ldgriffin88/go-kart-modeling/(list of files, cad)

Other CAD files:
cad-models/assemblies/Brake Caliper Assembly - Copy.SLDDRW
cad-models/assemblies/Brake Cylinder Assembly - Copy.SLDDRW
cad-models/assemblies/Brake Disc Assembly - Copy.SLDDRW
cad-models/assemblies/Front Right Subassembly - Copy.SLDDRW
cad-models/assemblies/Pedal Assembly - Copy.SLDDRW
cad-models/assemblies/Rear Axle Mount Assembly - Copy.SLDDRW
cad-models/assemblies/Rear Brake Assembly - Copy.SLDDRW
cad-models/assemblies/Rear Hub Assembly - Copy.SLDDRW
cad-models/assemblies/Sprocket Assembly - Copy.SLDDRW
cad-models/assemblies/Steering Rod Assembly - Copy.SLDDRW
cad-models/assemblies/Steering Wheel Assembly - Copy.SLDDRW
cad-models/parts/Brake Caliper - Original - Copy.SLDDRW
cad-models/parts/Brake Disc - Original - Copy.SLDDRW
cad-models/parts/Brake Disc Mount - Original - Copy.SLDDRW
cad-models/parts/Brake Frame Mount - Original - Copy.SLDDRW
cad-models/parts/Brake Lever - Original - Copy.SLDDRW
cad-models/parts/Brake Master Cyliner - Original - Copy.SLDDRW
cad-models/parts/Brake Mount - Original - Copy.SLDDRW
cad-models/parts/Brake Pad - Original - Copy.SLDDRW
cad-models/parts/Brake Pedal - Original - Copy.SLDDRW
cad-models/parts/Brake Piston - Original - Copy.SLDDRW
cad-models/parts/Engine Mount - Original - Copy.SLDDRW
cad-models/parts/Floor Plate - Original - Copy.SLDDRW
cad-models/parts/Floor Plate Tabs - Original - Copy.SLDDRW
cad-models/parts/Frame - Original - Copy.SLDDRW
cad-models/parts/Front Tire - Original - Copy.SLDDRW
cad-models/parts/Front Wheel Hub - Original - Copy.SLDDRW
cad-models/parts/Front Wheel Hub Connection - Original - Copy.SLDDRW
cad-models/parts/Gas Pedal - Original - Copy.SLDDRW
cad-models/parts/Half of Gear - Original - Copy.SLDDRW
cad-models/parts/Left Spindle - Original - Copy.SLDDRW
cad-models/parts/Pedal Rod - Original - Copy.SLDDRW
cad-models/parts/Rear Axle - Original - Copy.SLDDRW
cad-models/parts/Rear Axle Bearing Bracket - Original - Copy.SLDDRW
cad-models/parts/Rear Axle Bearing Mount - Original - Copy.SLDDRW
cad-models/parts/Rear Tire - Original - Copy.SLDDRW
cad-models/parts/Rear Wheel Hub - Original - Copy.SLDDRW
cad-models/parts/Rear Wheel Hub Connection - Original - Copy.SLDDRW
cad-models/parts/Spindle Collar - Original - Copy.SLDDRW
cad-models/parts/Sprocket Mount - Original - Copy.SLDDRW
cad-models/parts/Steering Rod - Original - Copy.SLDDRW
cad-models/parts/Steering Rod Standoff - Original - Copy.SLDDRW
cad-models/parts/Steering Shaft - Original - Copy.SLDDRW
cad-models/parts/Steering Wheel - Original - Copy.SLDDRW
