ldgriffin88/go-kart-modeling/drawings/assembly-drawings/Brake Caliper Assembly - Copy.pdf

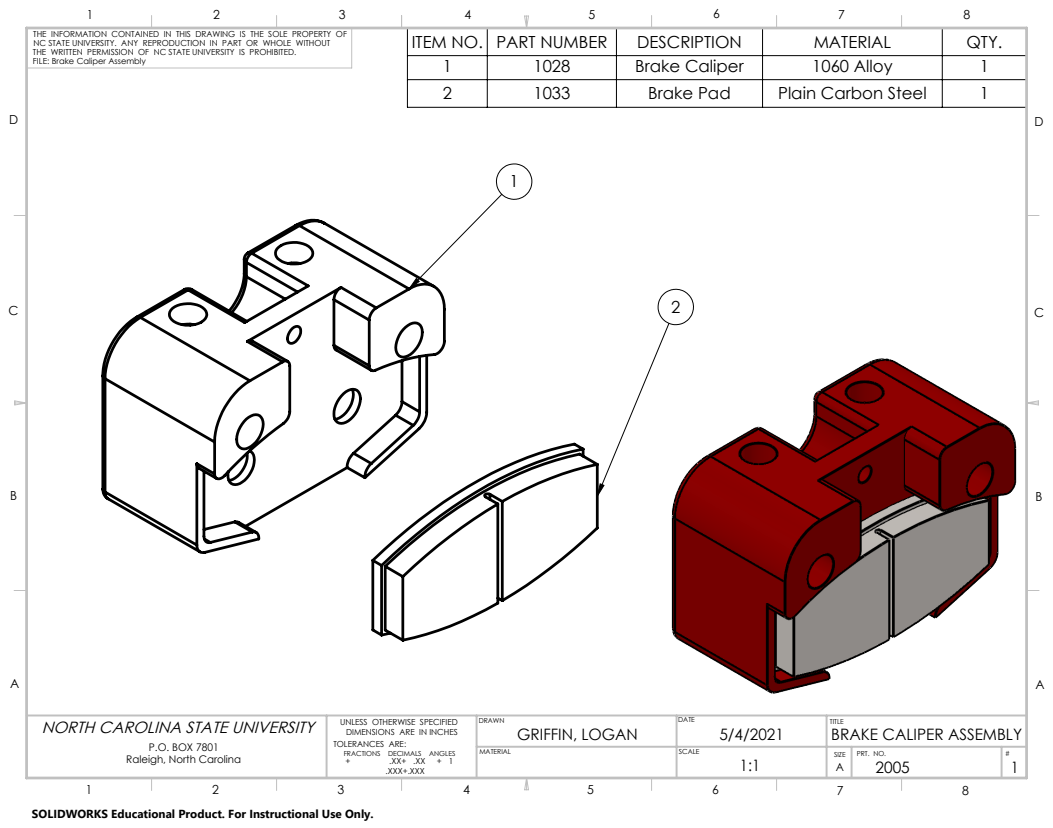
[picture p3: page 1]

THE INFORMATION CONTAINED IN THIS DRAWING IS THE SOLE PROPERTY OF
NC STATE UNIVERSITY. ANY REPRODUCTION IN PART OR WHOLE WITHOUT
THE WRITTEN PERMISSION OF NC STATE UNIVERSITY IS PROHIBITED.
FILE: Brake Caliper Assembly

ITEM NO. | PART NUMBER | DESCRIPTION | MATERIAL | QTY.
1 | 1028 | Brake Caliper | 1060 Alloy | 1
2 | 1033 | Brake Pad | Plain Carbon Steel | 1

P.O. BOX 7801 Raleigh, North Carolina | UNLESS OTHERWISE SPECIFIED NORTH CAROLINA STATE UNIVERSITY DIMENSIONS ARE IN INCHES TOLERANCES ARE: FRACTIONS DECIMALS ANGLES + .XX+ .XX + 1 .XXX+.XXX | DRAWN GRIFFIN, LOGAN MATERIAL | DATE 5/4/2021 | TITLE BRAKE CALIPER ASSEMBLY

SCALE 1:1 | SIZE A | PRT. NO. 2005 | # 1

SOLIDWORKS Educational Product. For Instructional Use Only.
