ldgriffin88/go-kart-modeling/drawings/assembly-drawings/Brake Cylinder Assembly - Copy.pdf

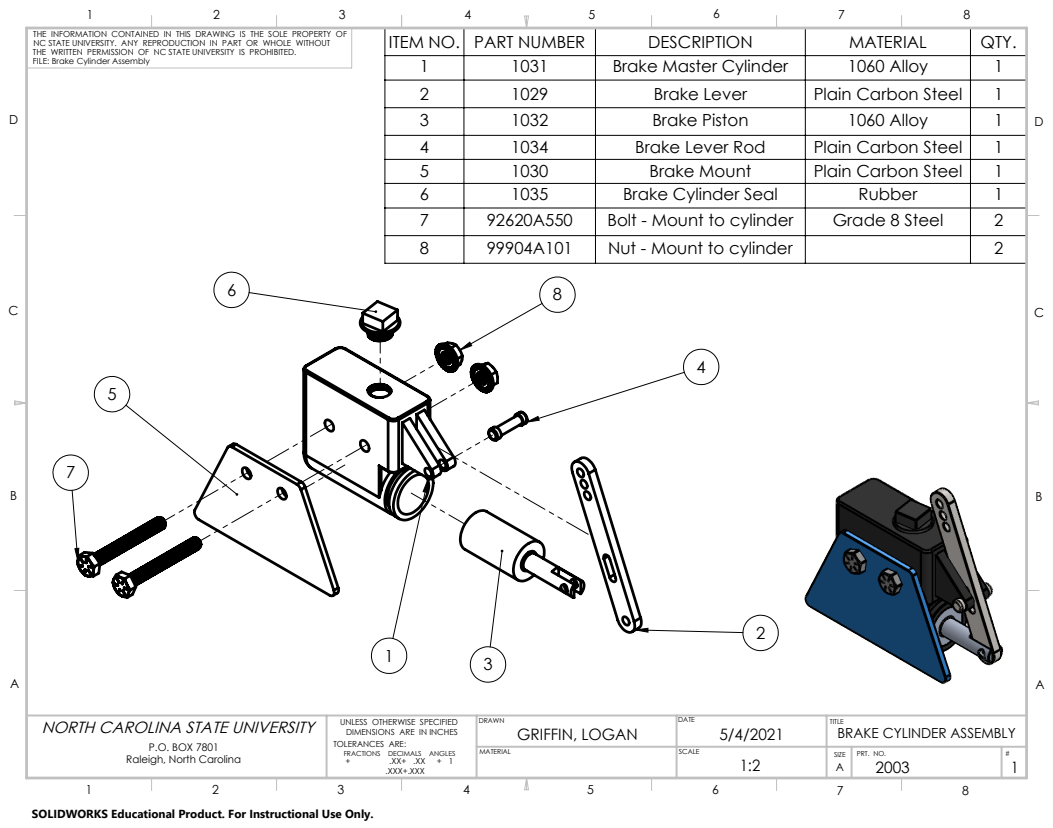
[picture p4: page 1]

THE INFORMATION CONTAINED IN THIS DRAWING IS THE SOLE PROPERTY OF
NC STATE UNIVERSITY. ANY REPRODUCTION IN PART OR WHOLE WITHOUT
THE WRITTEN PERMISSION OF NC STATE UNIVERSITY IS PROHIBITED.
FILE: Brake Cylinder Assembly

ITEM NO. | PART NUMBER | DESCRIPTION | MATERIAL | QTY.
1 | 1031 | Brake Master Cylinder | 1060 Alloy | 1
2 | 1029 | Brake Lever | Plain Carbon Steel | 1
3 | 1032 | Brake Piston | 1060 Alloy | 1
4 | 1034 | Brake Lever Rod | Plain Carbon Steel | 1
5 | 1030 | Brake Mount | Plain Carbon Steel | 1
6 | 1035 | Brake Cylinder Seal | Rubber | 1
7 | 92620A550 | Bolt - Mount to cylinder | Grade 8 Steel | 2
8 | 99904A101 | Nut - Mount to cylinder | | 2

P.O. BOX 7801 Raleigh, North Carolina | UNLESS OTHERWISE SPECIFIED NORTH CAROLINA STATE UNIVERSITY DIMENSIONS ARE IN INCHES TOLERANCES ARE: FRACTIONS DECIMALS ANGLES + .XX+ .XX + 1 .XXX+.XXX | DRAWN GRIFFIN, LOGAN MATERIAL | DATE 5/4/2021 | TITLE BRAKE CYLINDER ASSEMBLY

SCALE 1:2 | SIZE A | PRT. NO. 2003 | # 1

SOLIDWORKS Educational Product. For Instructional Use Only.
