ldgriffin88/go-kart-modeling/drawings/assembly-drawings/Brake Disc Assembly - Copy.pdf

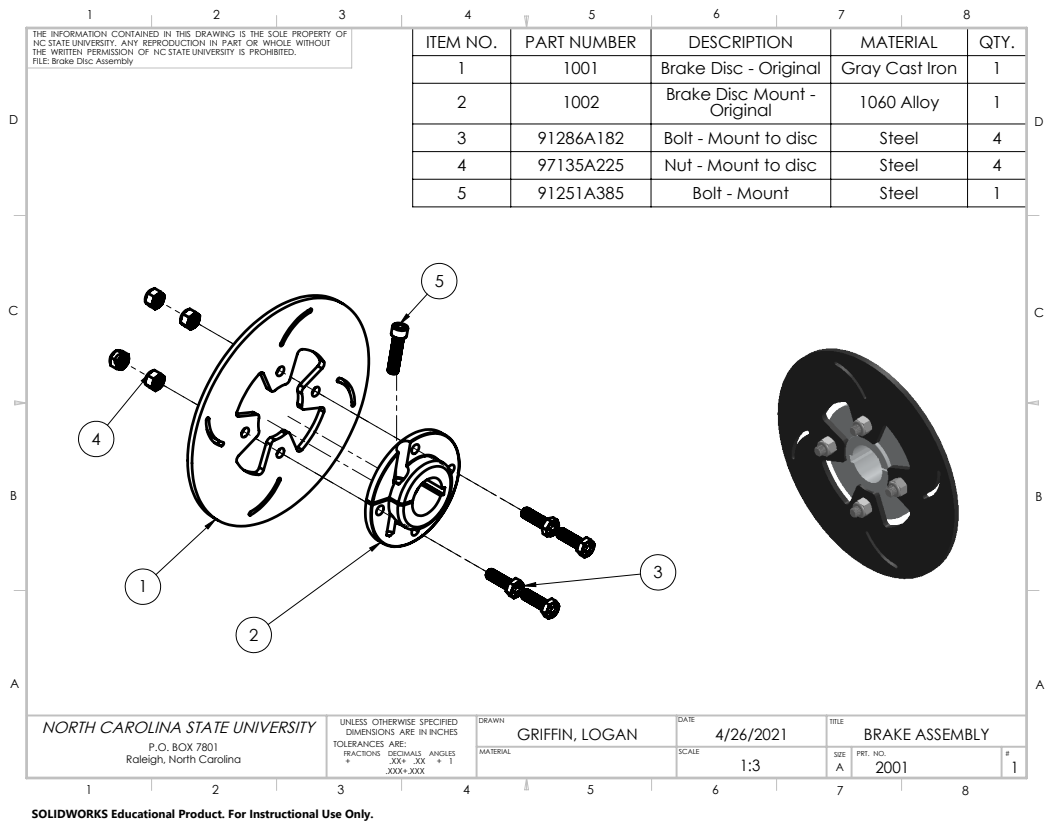
[picture p5: page 1]

THE INFORMATION CONTAINED IN THIS DRAWING IS THE SOLE PROPERTY OF
NC STATE UNIVERSITY. ANY REPRODUCTION IN PART OR WHOLE WITHOUT
THE WRITTEN PERMISSION OF NC STATE UNIVERSITY IS PROHIBITED.
FILE: Brake DIsc Assembly

ITEM NO. | PART NUMBER | DESCRIPTION | MATERIAL | QTY.
1 | 1001 | Brake Disc - Original | Gray Cast Iron | 1
2 | 1002 | Brake Disc Mount -Original | 1060 Alloy | 1

3 | 91286A182 | Bolt - Mount to disc | Steel | 4
4 | 97135A225 | Nut - Mount to disc | Steel | 4
5 | 91251A385 | Bolt - Mount | Steel | 1

P.O. BOX 7801 Raleigh, North Carolina | UNLESS OTHERWISE SPECIFIED NORTH CAROLINA STATE UNIVERSITY DIMENSIONS ARE IN INCHES TOLERANCES ARE: FRACTIONS DECIMALS ANGLES + .XX+ .XX + 1 .XXX+.XXX | DRAWN GRIFFIN, LOGAN MATERIAL | DATE 4/26/2021 | TITLE BRAKE ASSEMBLY

SCALE 1:3 | SIZE A | PRT. NO. 2001 | # 1

SOLIDWORKS Educational Product. For Instructional Use Only.
