ldgriffin88/go-kart-modeling/drawings/assembly-drawings/Front Right Subassembly - Copy.pdf

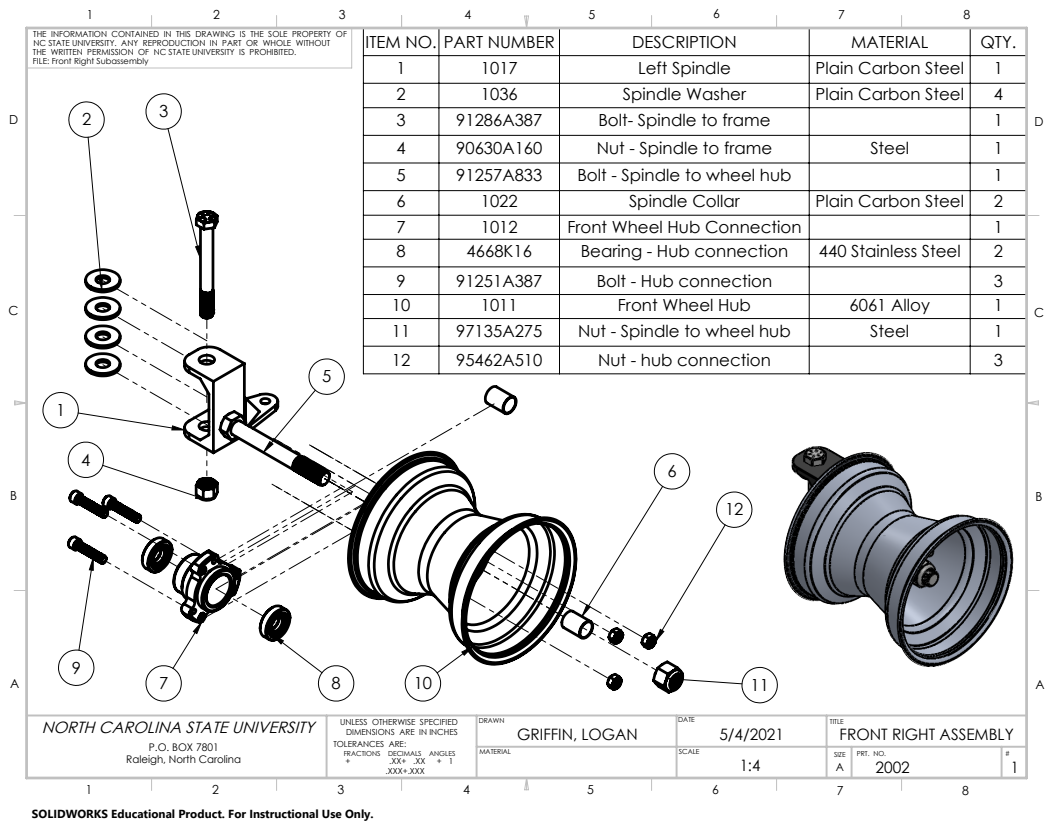
[picture p6: page 1]

THE INFORMATION CONTAINED IN THIS DRAWING IS THE SOLE PROPERTY OF
NC STATE UNIVERSITY. ANY REPRODUCTION IN PART OR WHOLE WITHOUT
THE WRITTEN PERMISSION OF NC STATE UNIVERSITY IS PROHIBITED.
FILE: Front Right Subassembly

ITEM NO. | PART NUMBER | DESCRIPTION | MATERIAL | QTY.
1 | 1017 | Left Spindle | Plain Carbon Steel | 1
2 | 1036 | Spindle Washer | Plain Carbon Steel | 4
3 | 91286A387 | Bolt- Spindle to frame | | 1
4 | 90630A160 | Nut - Spindle to frame | Steel | 1
5 | 91257A833 | Bolt - Spindle to wheel hub | | 1
6 | 1022 | Spindle Collar | Plain Carbon Steel | 2
7 | 1012 | Front Wheel Hub Connection | | 1
8 | 4668K16 | Bearing - Hub connection | 440 Stainless Steel | 2
9 | 91251A387 | Bolt - Hub connection | | 3
10 | 1011 | Front Wheel Hub | 6061 Alloy | 1
11 | 97135A275 | Nut - Spindle to wheel hub | Steel | 1
12 | 95462A510 | Nut - hub connection | | 3

P.O. BOX 7801 Raleigh, North Carolina | UNLESS OTHERWISE SPECIFIED NORTH CAROLINA STATE UNIVERSITY DIMENSIONS ARE IN INCHES TOLERANCES ARE: FRACTIONS DECIMALS ANGLES + .XX+ .XX + 1 .XXX+.XXX | DRAWN GRIFFIN, LOGAN MATERIAL | DATE 5/4/2021 | TITLE FRONT RIGHT ASSEMBLY

SCALE 1:4 | SIZE A | PRT. NO. 2002 | # 1

SOLIDWORKS Educational Product. For Instructional Use Only.
