ldgriffin88/go-kart-modeling/drawings/assembly-drawings/Pedal Assembly - Copy.pdf

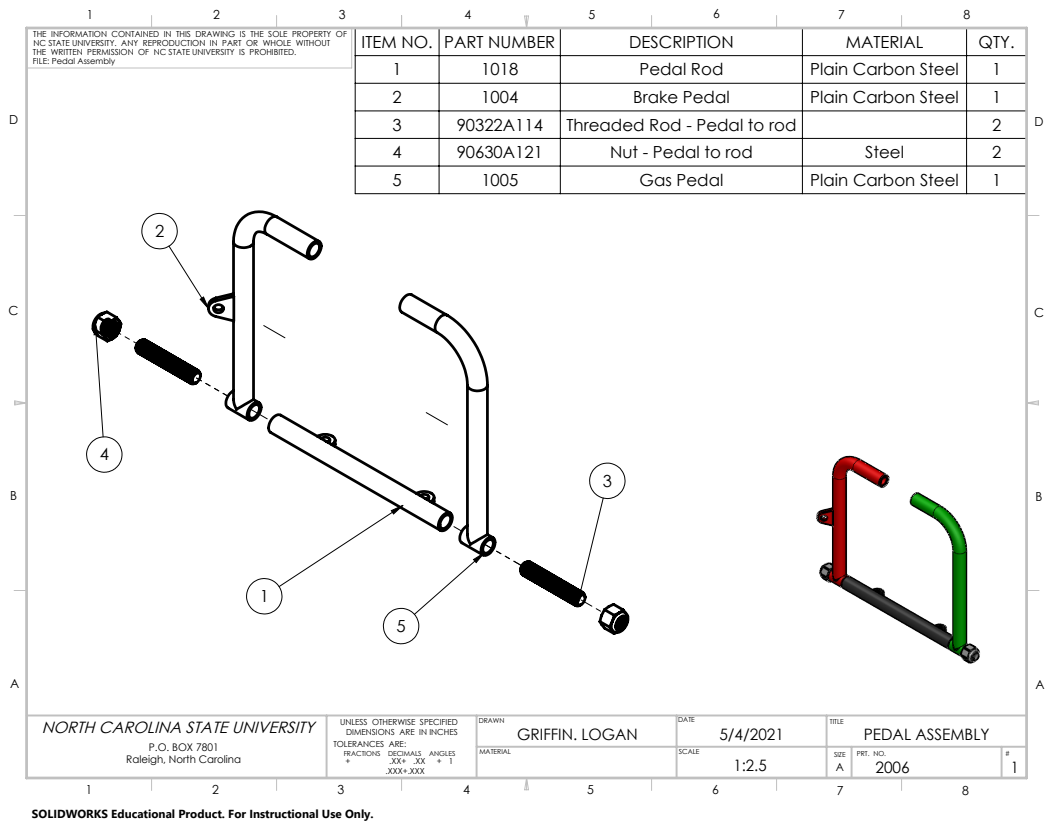
[picture p7: page 1]

THE INFORMATION CONTAINED IN THIS DRAWING IS THE SOLE PROPERTY OF
NC STATE UNIVERSITY. ANY REPRODUCTION IN PART OR WHOLE WITHOUT
THE WRITTEN PERMISSION OF NC STATE UNIVERSITY IS PROHIBITED.
FILE: Pedal Assembly

ITEM NO. | PART NUMBER | DESCRIPTION | MATERIAL | QTY.
1 | 1018 | Pedal Rod | Plain Carbon Steel | 1
2 | 1004 | Brake Pedal | Plain Carbon Steel | 1
3 | 90322A114 | Threaded Rod - Pedal to rod | | 2
4 | 90630A121 | Nut - Pedal to rod | Steel | 2
5 | 1005 | Gas Pedal | Plain Carbon Steel | 1

P.O. BOX 7801 Raleigh, North Carolina | UNLESS OTHERWISE SPECIFIED NORTH CAROLINA STATE UNIVERSITY DIMENSIONS ARE IN INCHES TOLERANCES ARE: FRACTIONS DECIMALS ANGLES + .XX+ .XX + 1 .XXX+.XXX | DRAWN GRIFFIN. LOGAN MATERIAL | DATE 5/4/2021 | TITLE PEDAL ASSEMBLY

SCALE 1:2.5 | SIZE A | PRT. NO. 2006 | # 1

SOLIDWORKS Educational Product. For Instructional Use Only.
