ldgriffin88/go-kart-modeling/drawings/assembly-drawings/Rear Axle Mount Assembly - Copy.pdf

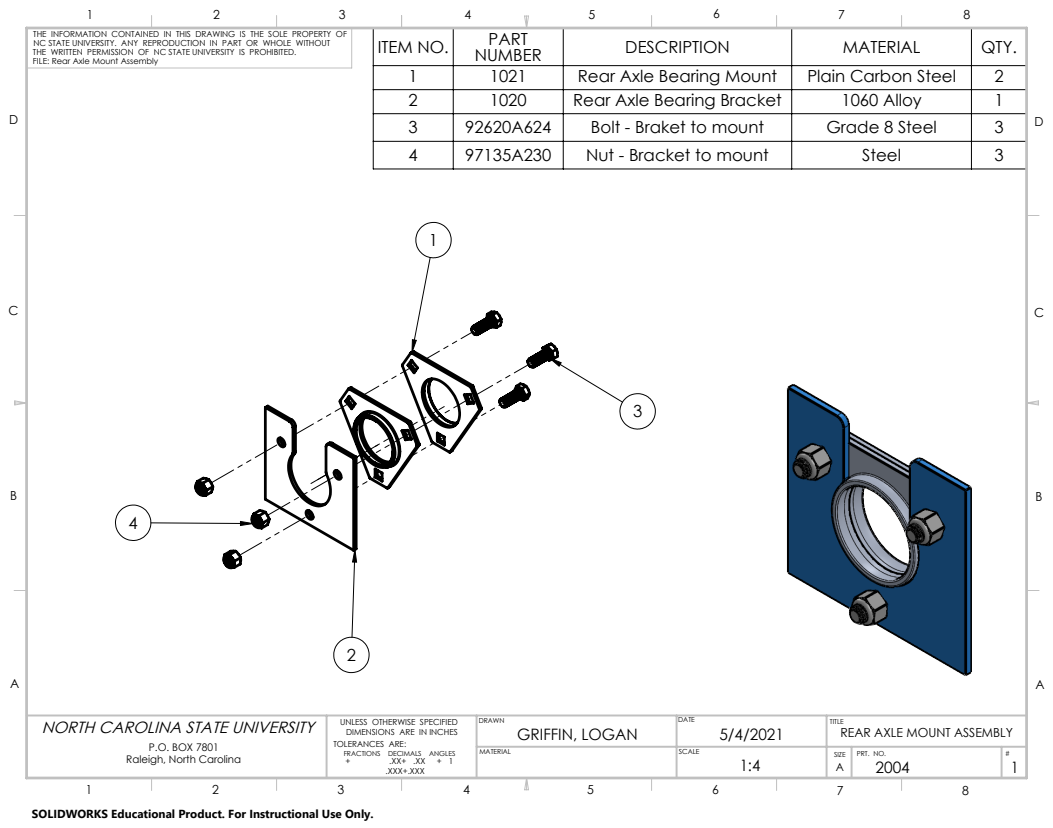
[picture p8: page 1]

THE INFORMATION CONTAINED IN THIS DRAWING IS THE SOLE PROPERTY OF
NC STATE UNIVERSITY. ANY REPRODUCTION IN PART OR WHOLE WITHOUT
THE WRITTEN PERMISSION OF NC STATE UNIVERSITY IS PROHIBITED.
FILE: Rear Axle Mount Assembly

ITEM NO. | PART NUMBER | DESCRIPTION | MATERIAL | QTY.
1 | 1021 | Rear Axle Bearing Mount | Plain Carbon Steel | 2
2 | 1020 | Rear Axle Bearing Bracket | 1060 Alloy | 1
3 | 92620A624 | Bolt - Braket to mount | Grade 8 Steel | 3
4 | 97135A230 | Nut - Bracket to mount | Steel | 3

P.O. BOX 7801 Raleigh, North Carolina | UNLESS OTHERWISE SPECIFIED NORTH CAROLINA STATE UNIVERSITY DIMENSIONS ARE IN INCHES TOLERANCES ARE: FRACTIONS DECIMALS ANGLES + .XX+ .XX + 1 .XXX+.XXX | DRAWN GRIFFIN, LOGAN MATERIAL | DATE 5/4/2021 | TITLE REAR AXLE MOUNT ASSEMBLY

SCALE 1:4 | SIZE A | PRT. NO. 2004 | # 1

SOLIDWORKS Educational Product. For Instructional Use Only.
