ldgriffin88/go-kart-modeling/drawings/assembly-drawings/Rear Brake Assembly - Copy.pdf

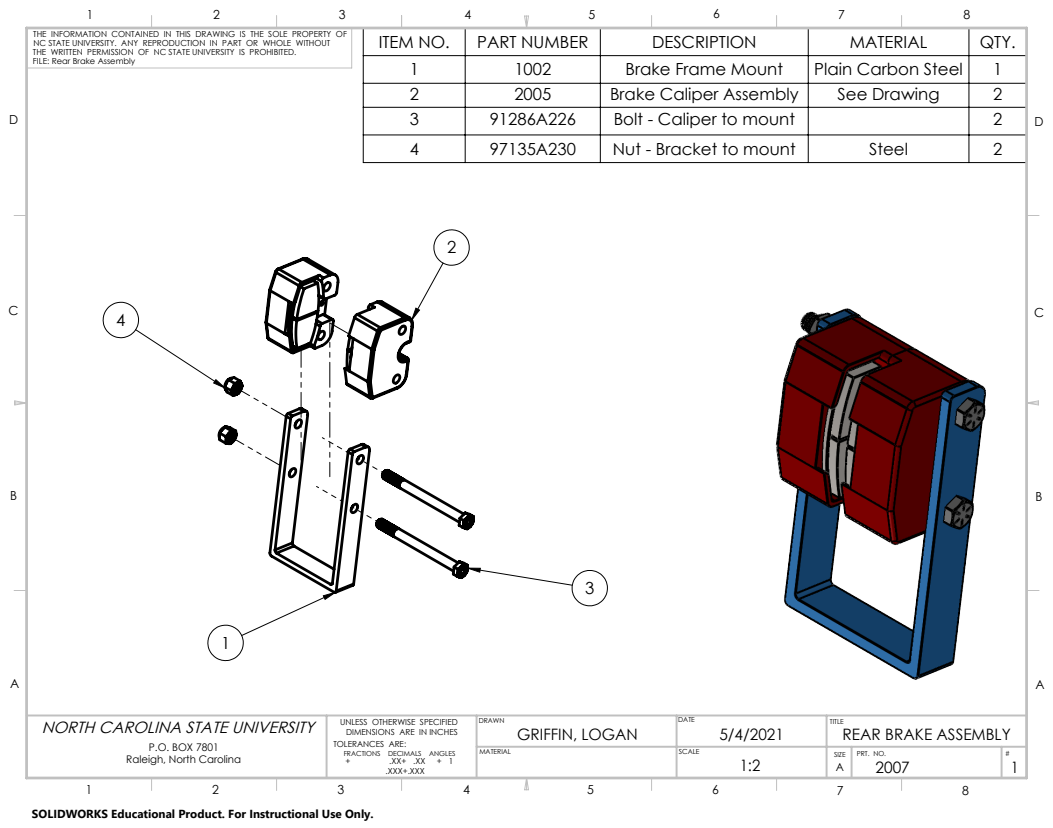
[picture p9: page 1]

THE INFORMATION CONTAINED IN THIS DRAWING IS THE SOLE PROPERTY OF
NC STATE UNIVERSITY. ANY REPRODUCTION IN PART OR WHOLE WITHOUT
THE WRITTEN PERMISSION OF NC STATE UNIVERSITY IS PROHIBITED.
FILE: Rear Brake Assembly

ITEM NO. | PART NUMBER | DESCRIPTION | MATERIAL | QTY.
1 | 1002 | Brake Frame Mount | Plain Carbon Steel | 1
2 | 2005 | Brake Caliper Assembly | See Drawing | 2
3 | 91286A226 | Bolt - Caliper to mount | | 2
4 | 97135A230 | Nut - Bracket to mount | Steel | 2

P.O. BOX 7801 Raleigh, North Carolina | UNLESS OTHERWISE SPECIFIED NORTH CAROLINA STATE UNIVERSITY DIMENSIONS ARE IN INCHES TOLERANCES ARE: FRACTIONS DECIMALS ANGLES + .XX+ .XX + 1 .XXX+.XXX | DRAWN GRIFFIN, LOGAN MATERIAL | DATE 5/4/2021 | TITLE REAR BRAKE ASSEMBLY

SCALE 1:2 | SIZE A | PRT. NO. 2007 | # 1

SOLIDWORKS Educational Product. For Instructional Use Only.
