ldgriffin88/go-kart-modeling/drawings/assembly-drawings/Rear Hub Assembly - Copy.pdf

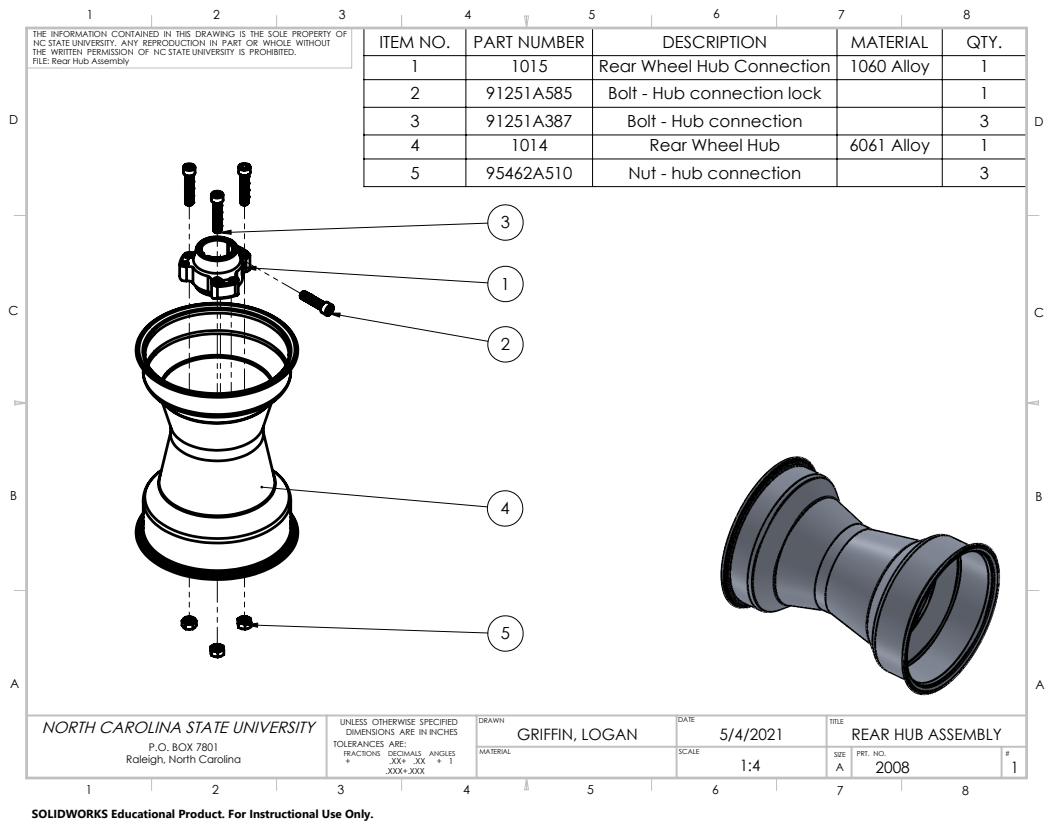
[picture p10: page 1]

THE INFORMATION CONTAINED IN THIS DRAWING IS THE SOLE PROPERTY OF
NC STATE UNIVERSITY. ANY REPRODUCTION IN PART OR WHOLE WITHOUT
THE WRITTEN PERMISSION OF NC STATE UNIVERSITY IS PROHIBITED.
FILE: Rear Hub Assembly

ITEM NO. | PART NUMBER | DESCRIPTION | MATERIAL | QTY.
1 | 1015 | Rear Wheel Hub Connection | 1060 Alloy | 1
2 | 91251A585 | Bolt - Hub connection lock | | 1
3 | 91251A387 | Bolt - Hub connection | | 3
4 | 1014 | Rear Wheel Hub | 6061 Alloy | 1
5 | 95462A510 | Nut - hub connection | | 3

P.O. BOX 7801 Raleigh, North Carolina | UNLESS OTHERWISE SPECIFIED NORTH CAROLINA STATE UNIVERSITY DIMENSIONS ARE IN INCHES TOLERANCES ARE: FRACTIONS DECIMALS ANGLES + .XX+ .XX + 1 .XXX+.XXX | DRAWN GRIFFIN, LOGAN MATERIAL | DATE 5/4/2021 | TITLE REAR HUB ASSEMBLY

SCALE 1:4 | SIZE A | PRT. NO. 2008 | # 1

SOLIDWORKS Educational Product. For Instructional Use Only.
