ldgriffin88/go-kart-modeling/drawings/assembly-drawings/Sprocket Assembly - Copy.pdf

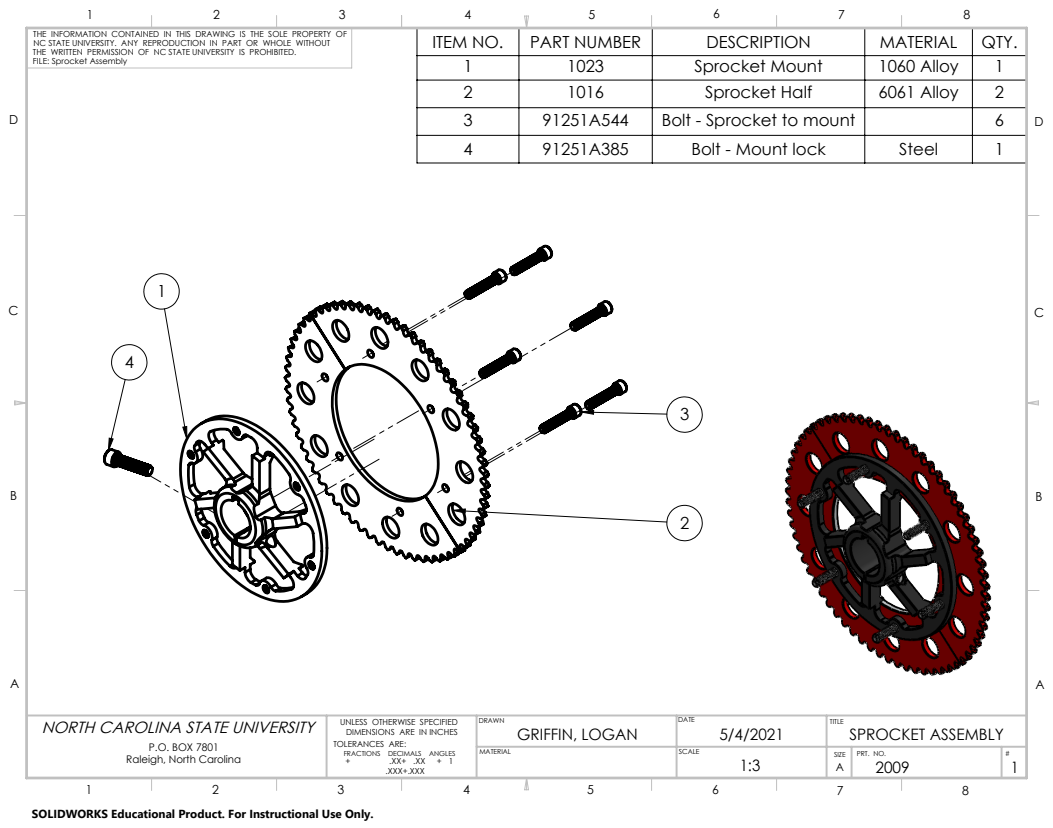
[picture p11: page 1]

THE INFORMATION CONTAINED IN THIS DRAWING IS THE SOLE PROPERTY OF
NC STATE UNIVERSITY. ANY REPRODUCTION IN PART OR WHOLE WITHOUT
THE WRITTEN PERMISSION OF NC STATE UNIVERSITY IS PROHIBITED.
FILE: Sprocket Assembly

ITEM NO. | PART NUMBER | DESCRIPTION | MATERIAL | QTY.
1 | 1023 | Sprocket Mount | 1060 Alloy | 1
2 | 1016 | Sprocket Half | 6061 Alloy | 2
3 | 91251A544 | Bolt - Sprocket to mount | | 6
4 | 91251A385 | Bolt - Mount lock | Steel | 1

P.O. BOX 7801 Raleigh, North Carolina | UNLESS OTHERWISE SPECIFIED NORTH CAROLINA STATE UNIVERSITY DIMENSIONS ARE IN INCHES TOLERANCES ARE: FRACTIONS DECIMALS ANGLES + .XX+ .XX + 1 .XXX+.XXX | DRAWN GRIFFIN, LOGAN MATERIAL | DATE 5/4/2021 | TITLE SPROCKET ASSEMBLY

SCALE 1:3 | SIZE A | PRT. NO. 2009 | # 1

SOLIDWORKS Educational Product. For Instructional Use Only.
