ldgriffin88/go-kart-modeling/drawings/assembly-drawings/Steering Rod Assembly - Copy.pdf

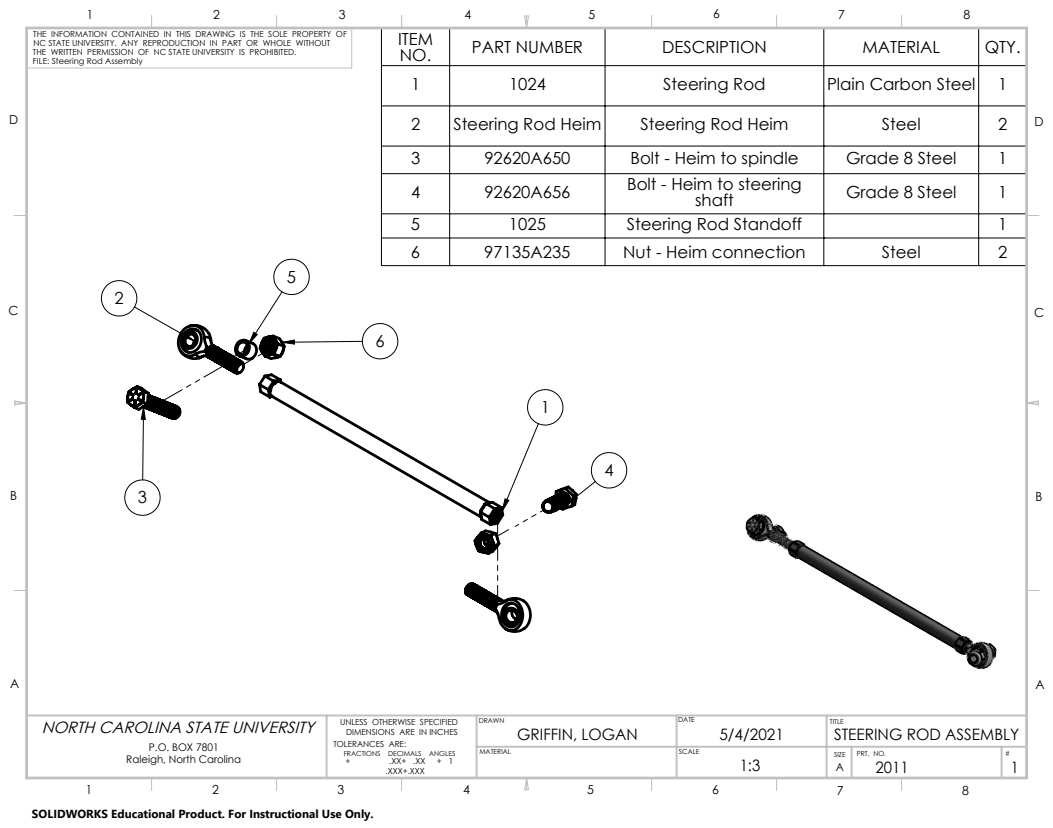
[picture p12: page 1]

THE INFORMATION CONTAINED IN THIS DRAWING IS THE SOLE PROPERTY OF
NC STATE UNIVERSITY. ANY REPRODUCTION IN PART OR WHOLE WITHOUT
THE WRITTEN PERMISSION OF NC STATE UNIVERSITY IS PROHIBITED.
FILE: Steering Rod Assembly

ITEM NO. | PART NUMBER | DESCRIPTION | MATERIAL | QTY.

1 | 1024 | Steering Rod | Plain Carbon Steel | 1
2 | Steering Rod Heim | Steering Rod Heim | Steel | 2
3 | 92620A650 | Bolt - Heim to spindle | Grade 8 Steel | 1
4 | 92620A656 | Bolt - Heim to steering shaft | Grade 8 Steel | 1
5 | 1025 | Steering Rod Standoff | | 1
6 | 97135A235 | Nut - Heim connection | Steel | 2

P.O. BOX 7801 Raleigh, North Carolina | UNLESS OTHERWISE SPECIFIED NORTH CAROLINA STATE UNIVERSITY DIMENSIONS ARE IN INCHES TOLERANCES ARE: FRACTIONS DECIMALS ANGLES + .XX+ .XX + 1 .XXX+.XXX | DRAWN GRIFFIN, LOGAN MATERIAL | DATE 5/4/2021 | TITLE STEERING ROD ASSEMBLY

SCALE 1:3 | SIZE A | PRT. NO. 2011 | # 1

SOLIDWORKS Educational Product. For Instructional Use Only.
