ldgriffin88/go-kart-modeling/drawings/assembly-drawings/Steering Wheel Assembly - Copy.pdf

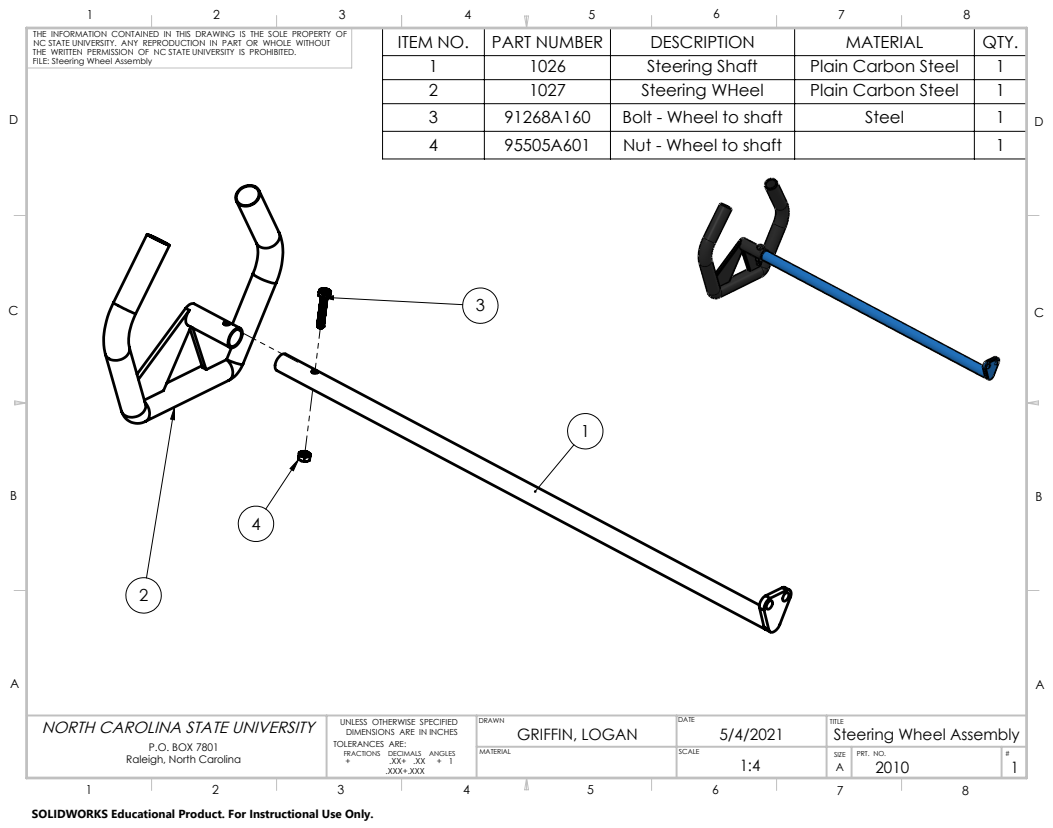
[picture p13: page 1]

THE INFORMATION CONTAINED IN THIS DRAWING IS THE SOLE PROPERTY OF
NC STATE UNIVERSITY. ANY REPRODUCTION IN PART OR WHOLE WITHOUT
THE WRITTEN PERMISSION OF NC STATE UNIVERSITY IS PROHIBITED.
FILE: Steering Wheel Assembly

ITEM NO. | PART NUMBER | DESCRIPTION | MATERIAL | QTY.
1 | 1026 | Steering Shaft | Plain Carbon Steel | 1
2 | 1027 | Steering WHeel | Plain Carbon Steel | 1
3 | 91268A160 | Bolt - Wheel to shaft | Steel | 1
4 | 95505A601 | Nut - Wheel to shaft | | 1

P.O. BOX 7801 Raleigh, North Carolina | UNLESS OTHERWISE SPECIFIED NORTH CAROLINA STATE UNIVERSITY DIMENSIONS ARE IN INCHES TOLERANCES ARE: FRACTIONS DECIMALS ANGLES + .XX+ .XX + 1 .XXX+.XXX | DRAWN GRIFFIN, LOGAN MATERIAL | DATE 5/4/2021 | TITLE Steering Wheel Assembly

SCALE 1:4 | SIZE A | PRT. NO. 2010 | # 1

SOLIDWORKS Educational Product. For Instructional Use Only.
