ldgriffin88/go-kart-modeling/drawings/part-drawings/Brake Caliper - Original - Copy.pdf

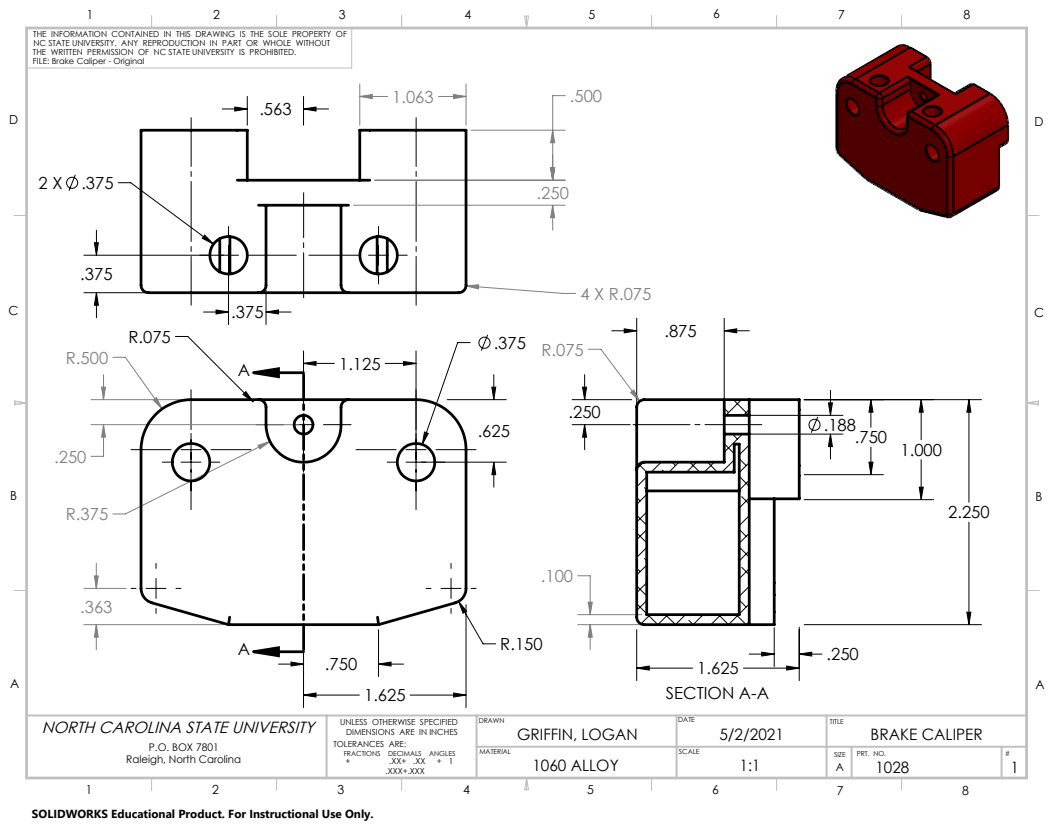
[picture p14: page 1]
SECTION A-A

THE INFORMATION CONTAINED IN THIS DRAWING IS THE SOLE PROPERTY OF
NC STATE UNIVERSITY. ANY REPRODUCTION IN PART OR WHOLE WITHOUT
THE WRITTEN PERMISSION OF NC STATE UNIVERSITY IS PROHIBITED.
FILE: Brake Caliper - Original

P.O. BOX 7801 Raleigh, North Carolina | UNLESS OTHERWISE SPECIFIED NORTH CAROLINA STATE UNIVERSITY DIMENSIONS ARE IN INCHES TOLERANCES ARE: FRACTIONS DECIMALS ANGLES + .XX+ .XX + 1 .XXX+.XXX | DRAWN GRIFFIN, LOGAN | DATE 5/2/2021 | TITLE BRAKE CALIPER

MATERIAL 1060 ALLOY | SCALE 1:1 | SIZE A | PRT. NO. 1028 | # 1

SOLIDWORKS Educational Product. For Instructional Use Only.
