ldgriffin88/go-kart-modeling/drawings/part-drawings/Brake Master Cyliner - Original - Copy.pdf

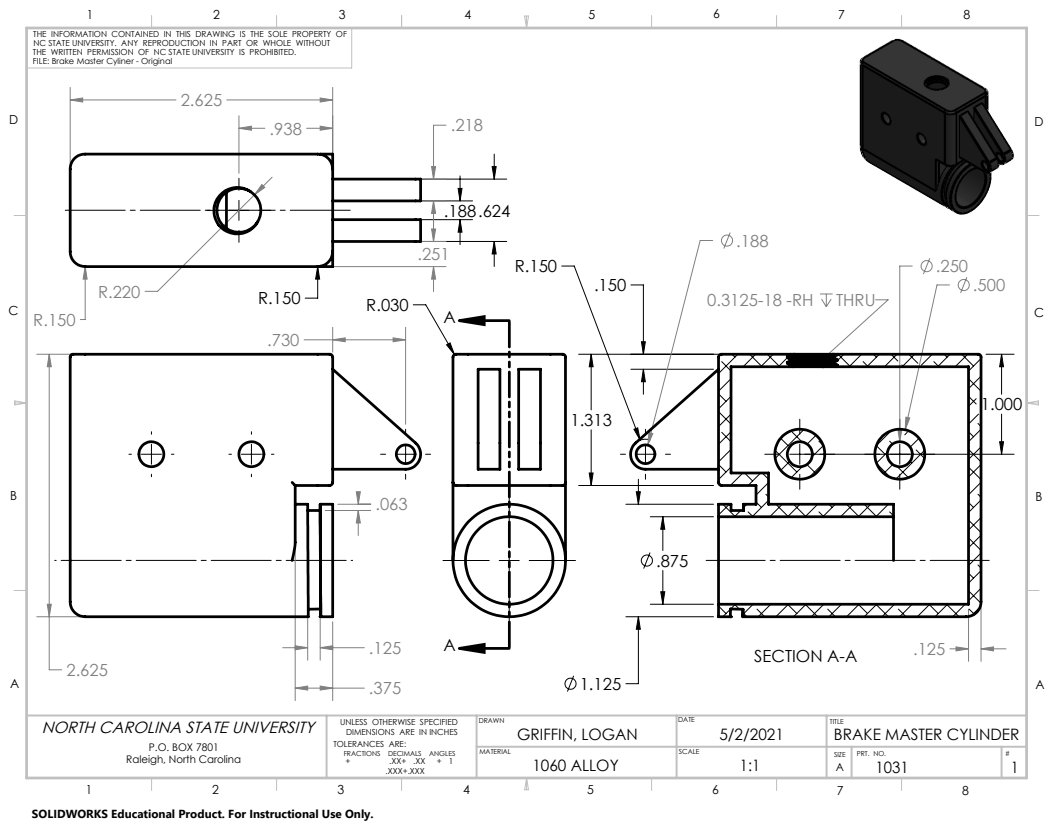
[picture p18: page 1]
0.3125-18 -RH THRU; SECTION A-A

THE INFORMATION CONTAINED IN THIS DRAWING IS THE SOLE PROPERTY OF
NC STATE UNIVERSITY. ANY REPRODUCTION IN PART OR WHOLE WITHOUT
THE WRITTEN PERMISSION OF NC STATE UNIVERSITY IS PROHIBITED.
FILE: Brake Master Cyliner - Original

P.O. BOX 7801 Raleigh, North Carolina | UNLESS OTHERWISE SPECIFIED NORTH CAROLINA STATE UNIVERSITY DIMENSIONS ARE IN INCHES TOLERANCES ARE: FRACTIONS DECIMALS ANGLES + .XX+ .XX + 1 .XXX+.XXX | DRAWN GRIFFIN, LOGAN | DATE 5/2/2021 | TITLE BRAKE MASTER CYLINDER

MATERIAL 1060 ALLOY | SCALE 1:1 | SIZE A | PRT. NO. 1031 | # 1

SOLIDWORKS Educational Product. For Instructional Use Only.
