ldgriffin88/go-kart-modeling/drawings/part-drawings/Brake Pedal - Original - Copy.pdf

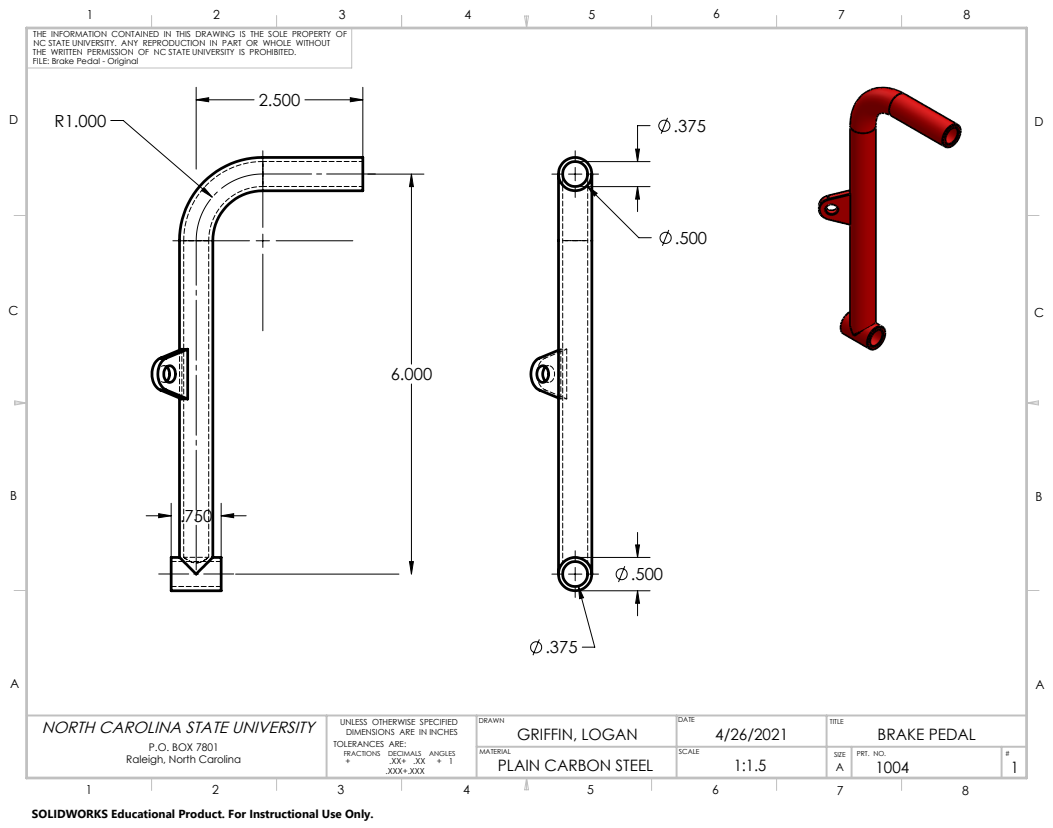
[picture p19: page 1]

THE INFORMATION CONTAINED IN THIS DRAWING IS THE SOLE PROPERTY OF
NC STATE UNIVERSITY. ANY REPRODUCTION IN PART OR WHOLE WITHOUT
THE WRITTEN PERMISSION OF NC STATE UNIVERSITY IS PROHIBITED.
FILE: Brake Pedal - Original

P.O. BOX 7801 Raleigh, North Carolina | UNLESS OTHERWISE SPECIFIED NORTH CAROLINA STATE UNIVERSITY DIMENSIONS ARE IN INCHES TOLERANCES ARE: FRACTIONS DECIMALS ANGLES + .XX+ .XX + 1 .XXX+.XXX | DRAWN GRIFFIN, LOGAN | DATE 4/26/2021 | TITLE BRAKE PEDAL

MATERIAL PLAIN CARBON STEEL | SCALE 1:1.5 | SIZE A | PRT. NO. 1004 | # 1

SOLIDWORKS Educational Product. For Instructional Use Only.
