ldgriffin88/go-kart-modeling/drawings/part-drawings/Engine Mount - Original - Copy.pdf

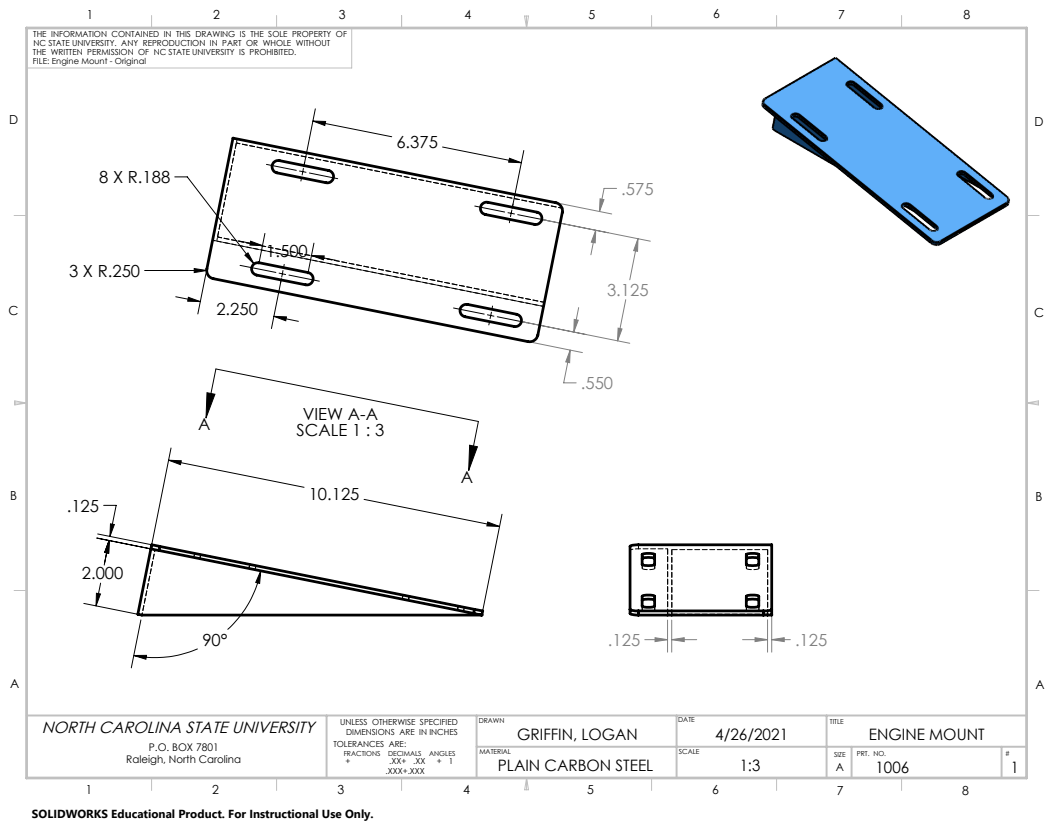
[picture p20: page 1]
VIEW A-A SCALE 1 : 3

THE INFORMATION CONTAINED IN THIS DRAWING IS THE SOLE PROPERTY OF
NC STATE UNIVERSITY. ANY REPRODUCTION IN PART OR WHOLE WITHOUT
THE WRITTEN PERMISSION OF NC STATE UNIVERSITY IS PROHIBITED.
FILE: Engine Mount - Original

P.O. BOX 7801 Raleigh, North Carolina | UNLESS OTHERWISE SPECIFIED NORTH CAROLINA STATE UNIVERSITY DIMENSIONS ARE IN INCHES TOLERANCES ARE: FRACTIONS DECIMALS ANGLES + .XX+ .XX + 1 .XXX+.XXX | DRAWN GRIFFIN, LOGAN | DATE 4/26/2021 | TITLE ENGINE MOUNT

MATERIAL PLAIN CARBON STEEL | SCALE 1:3 | SIZE A | PRT. NO. 1006 | # 1

SOLIDWORKS Educational Product. For Instructional Use Only.
