ldgriffin88/go-kart-modeling/drawings/part-drawings/Floor Plate - Original - Copy.pdf

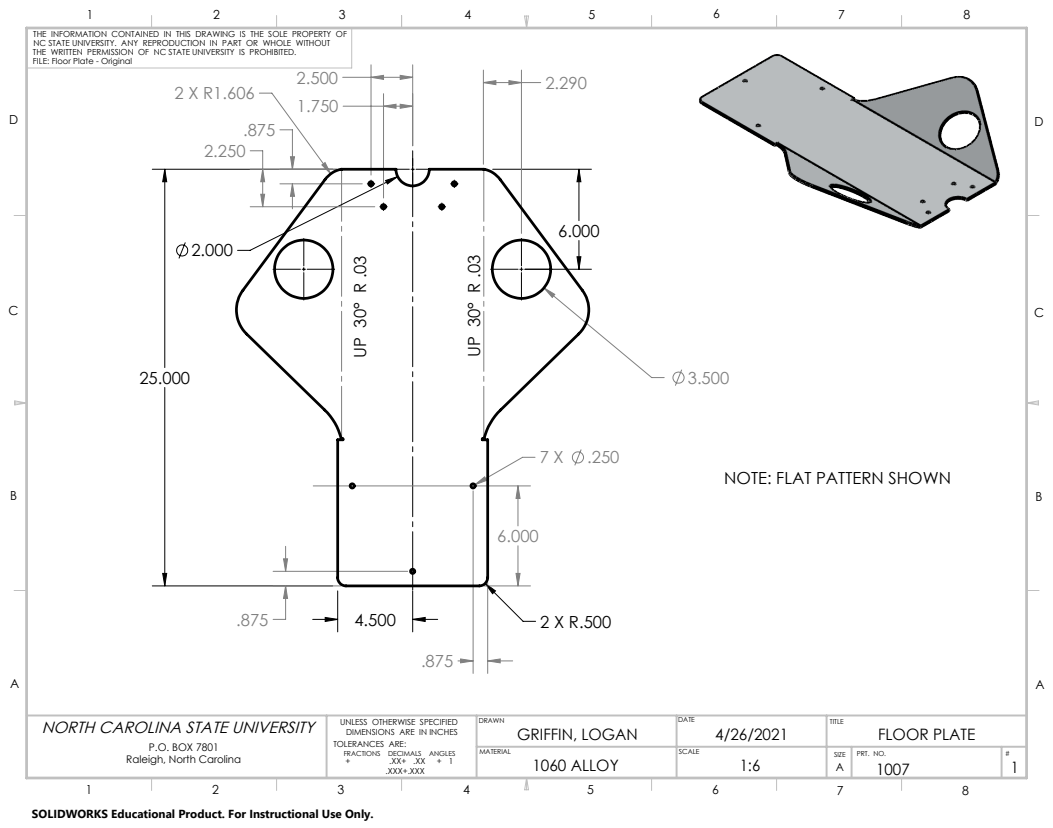
[picture p21: page 1]

THE INFORMATION CONTAINED IN THIS DRAWING IS THE SOLE PROPERTY OF
NC STATE UNIVERSITY. ANY REPRODUCTION IN PART OR WHOLE WITHOUT
THE WRITTEN PERMISSION OF NC STATE UNIVERSITY IS PROHIBITED.
FILE: Floor Plate - Original

NOTE: FLAT PATTERN SHOWN

P.O. BOX 7801 Raleigh, North Carolina | UNLESS OTHERWISE SPECIFIED NORTH CAROLINA STATE UNIVERSITY DIMENSIONS ARE IN INCHES TOLERANCES ARE: FRACTIONS DECIMALS ANGLES + .XX+ .XX + 1 .XXX+.XXX | DRAWN GRIFFIN, LOGAN | DATE 4/26/2021 | TITLE FLOOR PLATE

MATERIAL 1060 ALLOY | SCALE 1:6 | SIZE A | PRT. NO. 1007 | # 1

SOLIDWORKS Educational Product. For Instructional Use Only.
