ldgriffin88/go-kart-modeling/drawings/part-drawings/Frame - Original - Copy.pdf

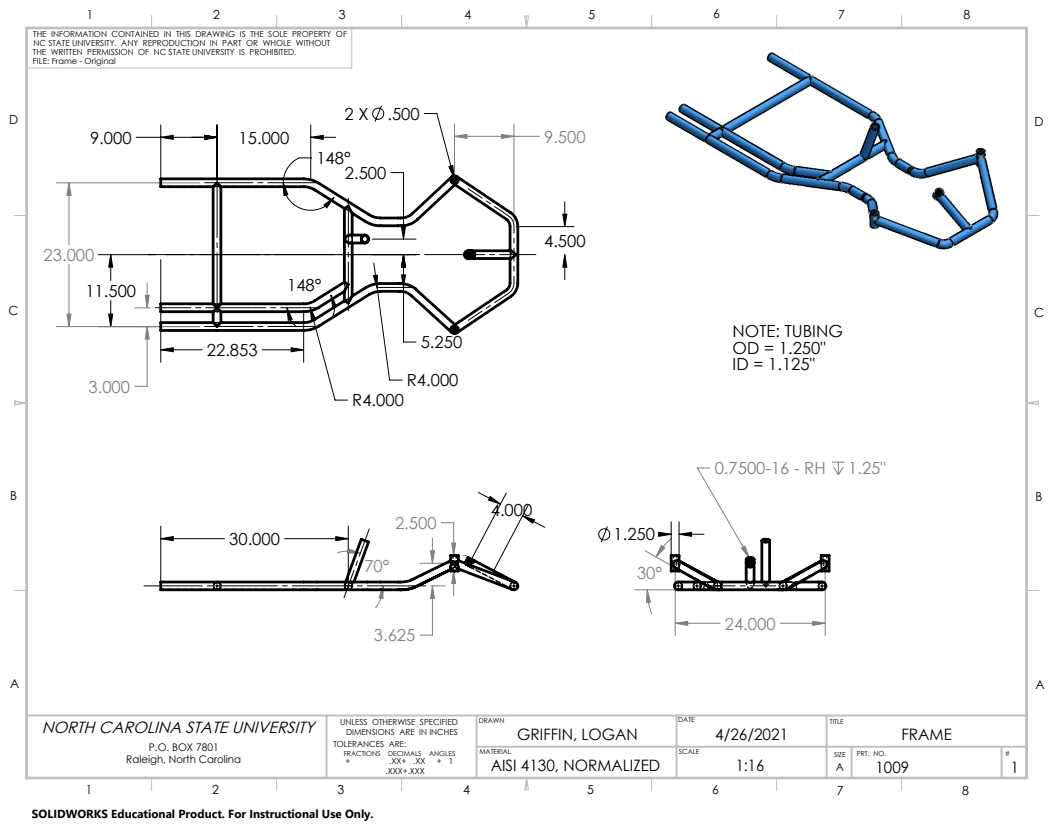
[picture p23: page 1]
NOTE: TUBING OD = 1.250" ID = 1.125"

THE INFORMATION CONTAINED IN THIS DRAWING IS THE SOLE PROPERTY OF
NC STATE UNIVERSITY. ANY REPRODUCTION IN PART OR WHOLE WITHOUT
THE WRITTEN PERMISSION OF NC STATE UNIVERSITY IS PROHIBITED.
FILE: Frame - Original

P.O. BOX 7801 Raleigh, North Carolina | UNLESS OTHERWISE SPECIFIED NORTH CAROLINA STATE UNIVERSITY DIMENSIONS ARE IN INCHES TOLERANCES ARE: FRACTIONS DECIMALS ANGLES + .XX+ .XX + 1 .XXX+.XXX | DRAWN GRIFFIN, LOGAN | DATE 4/26/2021 | TITLE FRAME

MATERIAL AISI 4130, NORMALIZED | SCALE 1:16 | SIZE A | PRT. NO. 1009 | # 1

SOLIDWORKS Educational Product. For Instructional Use Only.
