ldgriffin88/go-kart-modeling/drawings/part-drawings/Front Tire - Original - Copy.pdf

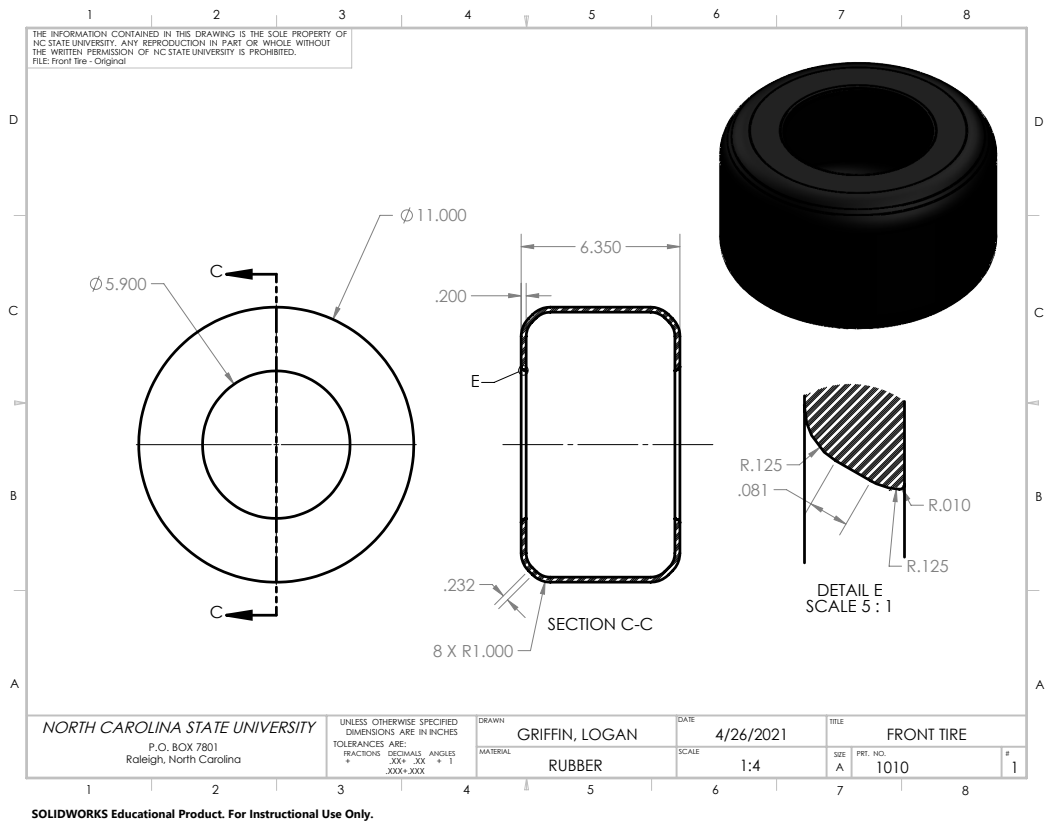
[picture p24: page 1]
SECTION C-C; DETAIL E SCALE 5 : 1

THE INFORMATION CONTAINED IN THIS DRAWING IS THE SOLE PROPERTY OF
NC STATE UNIVERSITY. ANY REPRODUCTION IN PART OR WHOLE WITHOUT
THE WRITTEN PERMISSION OF NC STATE UNIVERSITY IS PROHIBITED.
FILE: Front Tire - Original

P.O. BOX 7801 Raleigh, North Carolina | UNLESS OTHERWISE SPECIFIED NORTH CAROLINA STATE UNIVERSITY DIMENSIONS ARE IN INCHES TOLERANCES ARE: FRACTIONS DECIMALS ANGLES + .XX+ .XX + 1 .XXX+.XXX | DRAWN GRIFFIN, LOGAN | DATE 4/26/2021 | TITLE FRONT TIRE

MATERIAL RUBBER | SCALE 1:4 | SIZE A | PRT. NO. 1010 | # 1

SOLIDWORKS Educational Product. For Instructional Use Only.
