ldgriffin88/go-kart-modeling/drawings/part-drawings/Front Wheel Hub Connection - Original - Copy.pdf

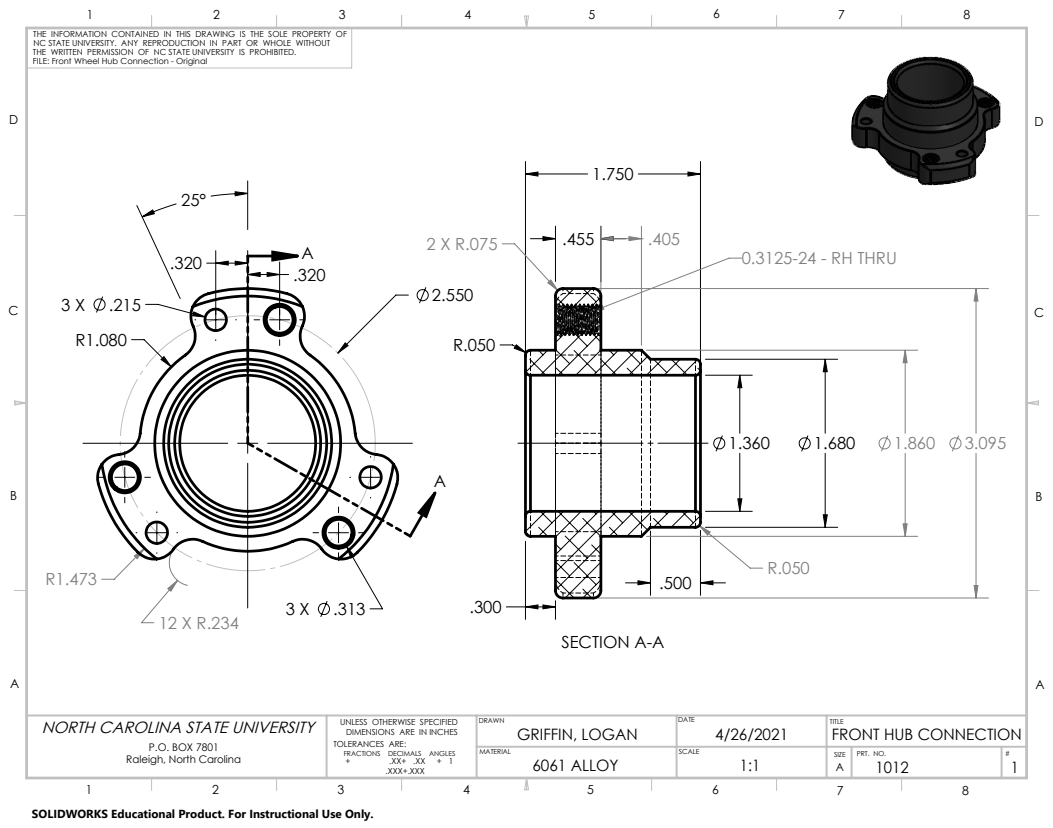
[picture p26: page 1]
0.3125-24 - RH THRU; SECTION A-A

THE INFORMATION CONTAINED IN THIS DRAWING IS THE SOLE PROPERTY OF
NC STATE UNIVERSITY. ANY REPRODUCTION IN PART OR WHOLE WITHOUT
THE WRITTEN PERMISSION OF NC STATE UNIVERSITY IS PROHIBITED.
FILE: Front Wheel Hub Connection - Original

P.O. BOX 7801 Raleigh, North Carolina | UNLESS OTHERWISE SPECIFIED NORTH CAROLINA STATE UNIVERSITY DIMENSIONS ARE IN INCHES TOLERANCES ARE: FRACTIONS DECIMALS ANGLES + .XX+ .XX + 1 .XXX+.XXX | DRAWN GRIFFIN, LOGAN | DATE 4/26/2021 | TITLE FRONT HUB CONNECTION

MATERIAL 6061 ALLOY | SCALE 1:1 | SIZE A | PRT. NO. 1012 | # 1

SOLIDWORKS Educational Product. For Instructional Use Only.
