ldgriffin88/go-kart-modeling/drawings/part-drawings/Half of Gear - Original - Copy.pdf

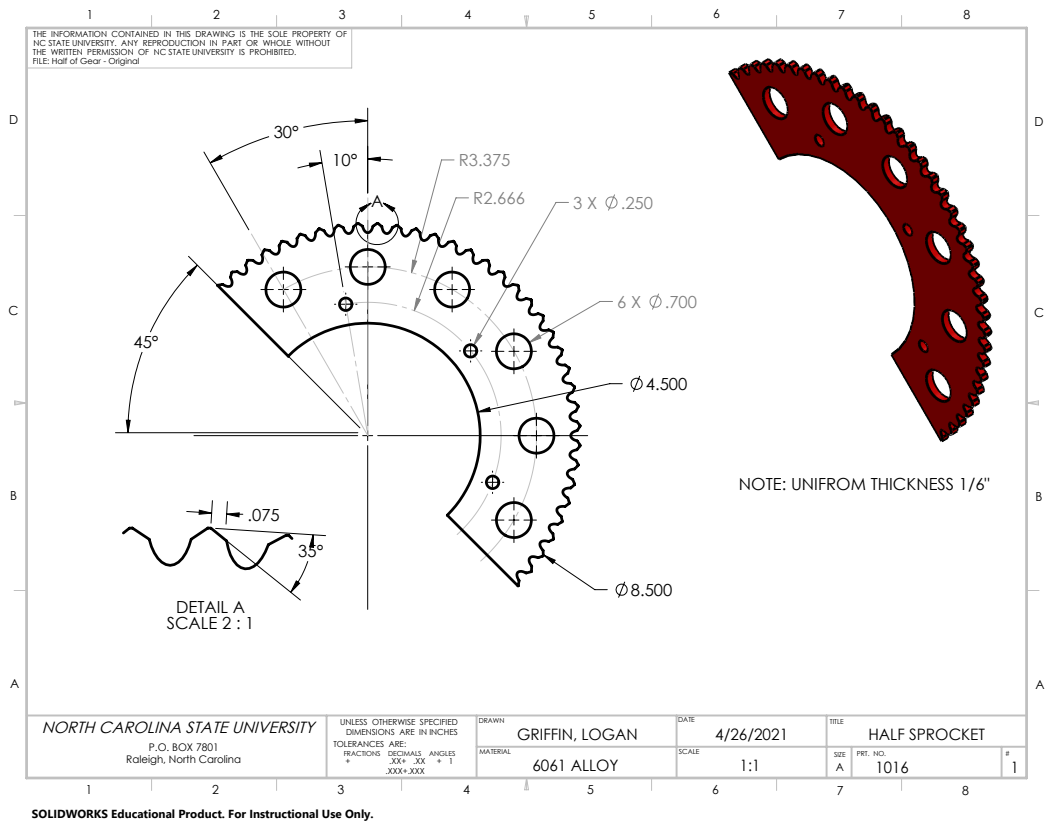
[picture p27: page 1]
DETAIL A SCALE 2 : 1

THE INFORMATION CONTAINED IN THIS DRAWING IS THE SOLE PROPERTY OF
NC STATE UNIVERSITY. ANY REPRODUCTION IN PART OR WHOLE WITHOUT
THE WRITTEN PERMISSION OF NC STATE UNIVERSITY IS PROHIBITED.
FILE: Half of Gear - Original

NOTE: UNIFROM THICKNESS 1/6"

P.O. BOX 7801 Raleigh, North Carolina | UNLESS OTHERWISE SPECIFIED NORTH CAROLINA STATE UNIVERSITY DIMENSIONS ARE IN INCHES TOLERANCES ARE: FRACTIONS DECIMALS ANGLES + .XX+ .XX + 1 .XXX+.XXX | DRAWN GRIFFIN, LOGAN | DATE 4/26/2021 | TITLE HALF SPROCKET

MATERIAL 6061 ALLOY | SCALE 1:1 | SIZE A | PRT. NO. 1016 | # 1

SOLIDWORKS Educational Product. For Instructional Use Only.
