ldgriffin88/go-kart-modeling/drawings/part-drawings/Rear Axle - Original - Copy.PDF

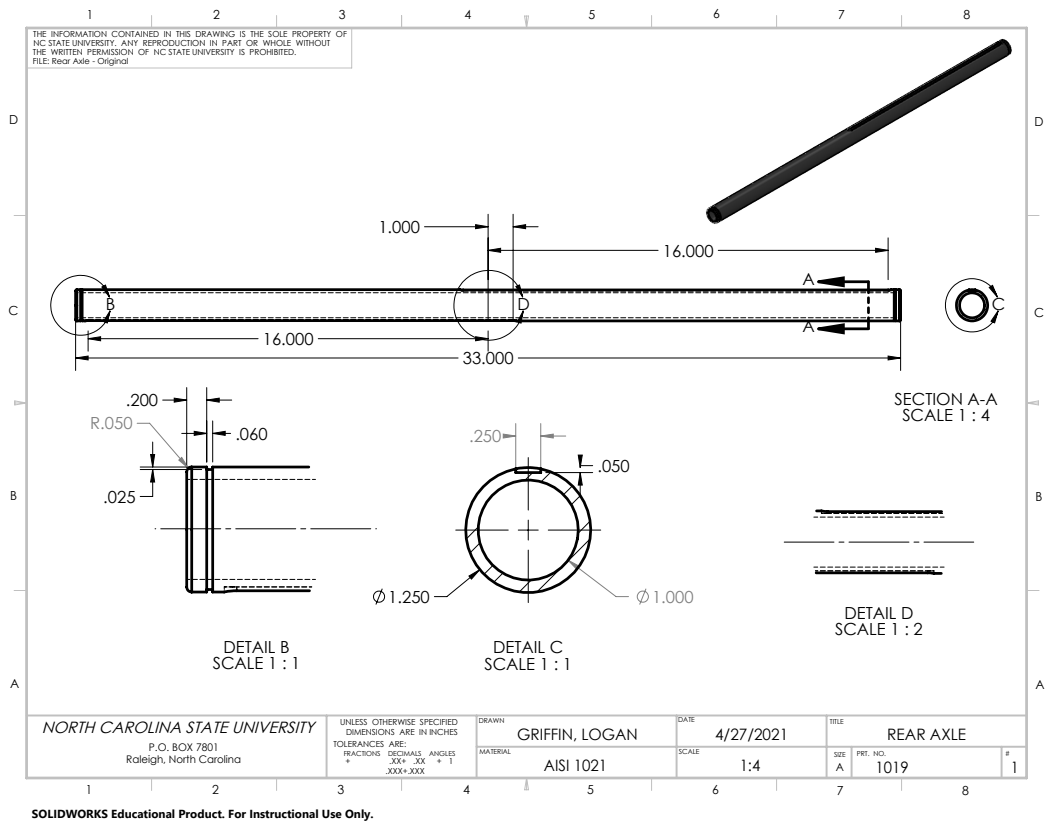
[picture p29: page 1]
SECTION A-A SCALE 1 : 4; DETAIL B SCALE 1 : 1; DETAIL C SCALE 1 : 1; DETAIL D SCALE 1 : 2

THE INFORMATION CONTAINED IN THIS DRAWING IS THE SOLE PROPERTY OF
NC STATE UNIVERSITY. ANY REPRODUCTION IN PART OR WHOLE WITHOUT
THE WRITTEN PERMISSION OF NC STATE UNIVERSITY IS PROHIBITED.
FILE: Rear Axle - Original

P.O. BOX 7801 Raleigh, North Carolina | UNLESS OTHERWISE SPECIFIED NORTH CAROLINA STATE UNIVERSITY DIMENSIONS ARE IN INCHES TOLERANCES ARE: FRACTIONS DECIMALS ANGLES + .XX+ .XX + 1 .XXX+.XXX | DRAWN GRIFFIN, LOGAN | DATE 4/27/2021 | TITLE REAR AXLE

MATERIAL AISI 1021 | SCALE 1:4 | SIZE A | PRT. NO. 1019 | # 1

SOLIDWORKS Educational Product. For Instructional Use Only.
