ldgriffin88/go-kart-modeling/drawings/part-drawings/Steering Rod - Original - Copy.pdf

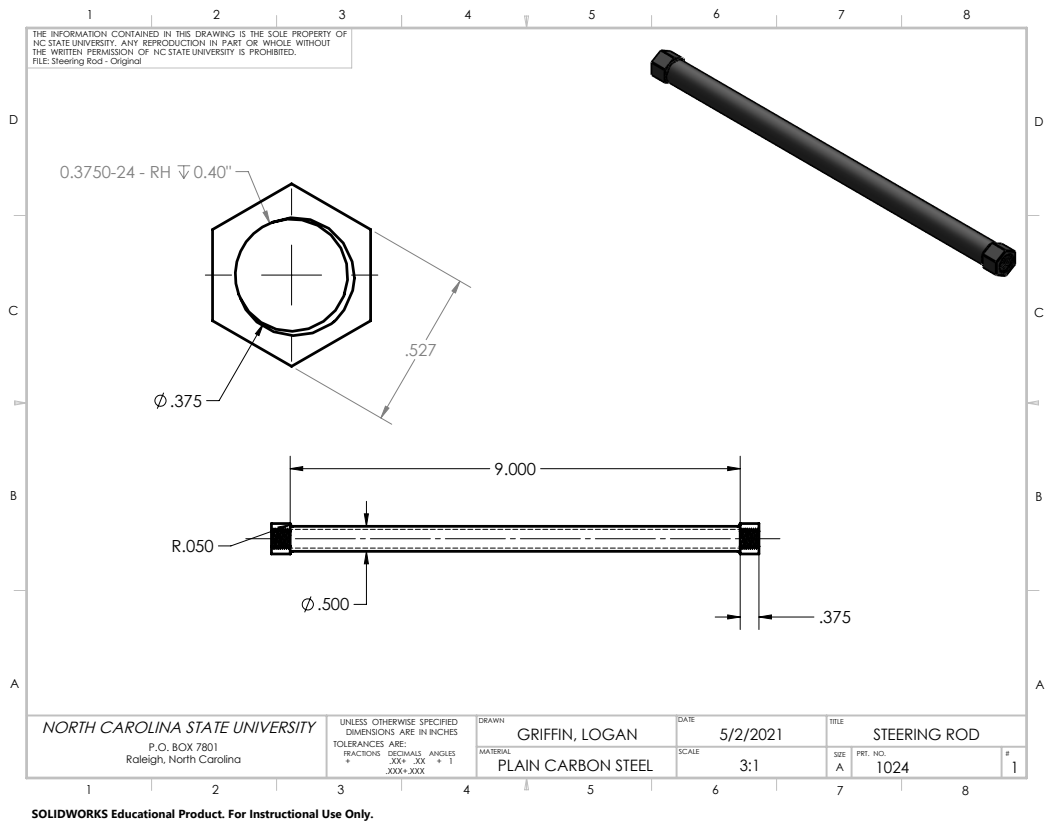
[picture p34: page 1]

THE INFORMATION CONTAINED IN THIS DRAWING IS THE SOLE PROPERTY OF
NC STATE UNIVERSITY. ANY REPRODUCTION IN PART OR WHOLE WITHOUT
THE WRITTEN PERMISSION OF NC STATE UNIVERSITY IS PROHIBITED.
FILE: Steering Rod - Original

P.O. BOX 7801 Raleigh, North Carolina | UNLESS OTHERWISE SPECIFIED NORTH CAROLINA STATE UNIVERSITY DIMENSIONS ARE IN INCHES TOLERANCES ARE: FRACTIONS DECIMALS ANGLES + .XX+ .XX + 1 .XXX+.XXX | DRAWN GRIFFIN, LOGAN | DATE 5/2/2021 | TITLE STEERING ROD

MATERIAL PLAIN CARBON STEEL | SCALE 3:1 | SIZE A | PRT. NO. 1024 | # 1

SOLIDWORKS Educational Product. For Instructional Use Only.
