ldgriffin88/go-kart-modeling/drawings/part-drawings/Steering Rod Standoff - Original - Copy.pdf

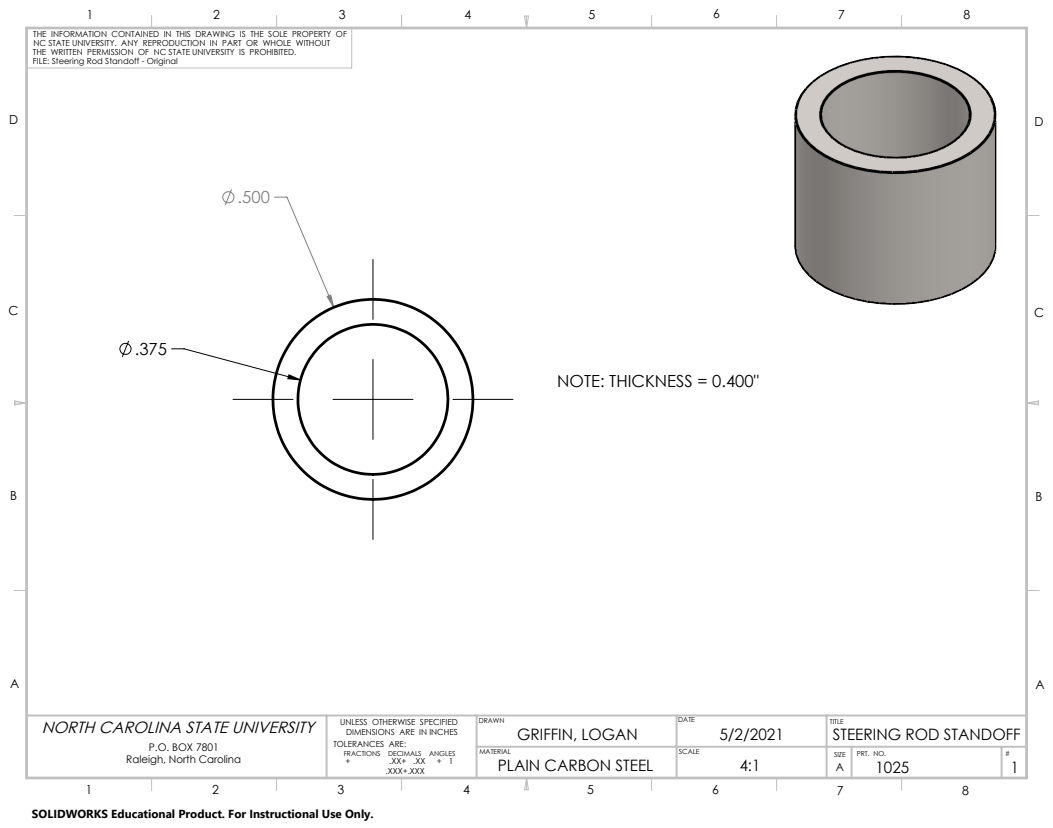
[picture p35: page 1]
NOTE: THICKNESS = 0.400"

THE INFORMATION CONTAINED IN THIS DRAWING IS THE SOLE PROPERTY OF
NC STATE UNIVERSITY. ANY REPRODUCTION IN PART OR WHOLE WITHOUT
THE WRITTEN PERMISSION OF NC STATE UNIVERSITY IS PROHIBITED.
FILE: Steering Rod Standoff - Original

P.O. BOX 7801 Raleigh, North Carolina | UNLESS OTHERWISE SPECIFIED NORTH CAROLINA STATE UNIVERSITY DIMENSIONS ARE IN INCHES TOLERANCES ARE: FRACTIONS DECIMALS ANGLES + .XX+ .XX + 1 .XXX+.XXX | DRAWN GRIFFIN, LOGAN | DATE 5/2/2021 | TITLE STEERING ROD STANDOFF

MATERIAL PLAIN CARBON STEEL | SCALE 4:1 | SIZE A | PRT. NO. 1025 | # 1

SOLIDWORKS Educational Product. For Instructional Use Only.
