ldgriffin88/go-kart-modeling/drawings/part-drawings/Steering Shaft - Original - Copy.pdf

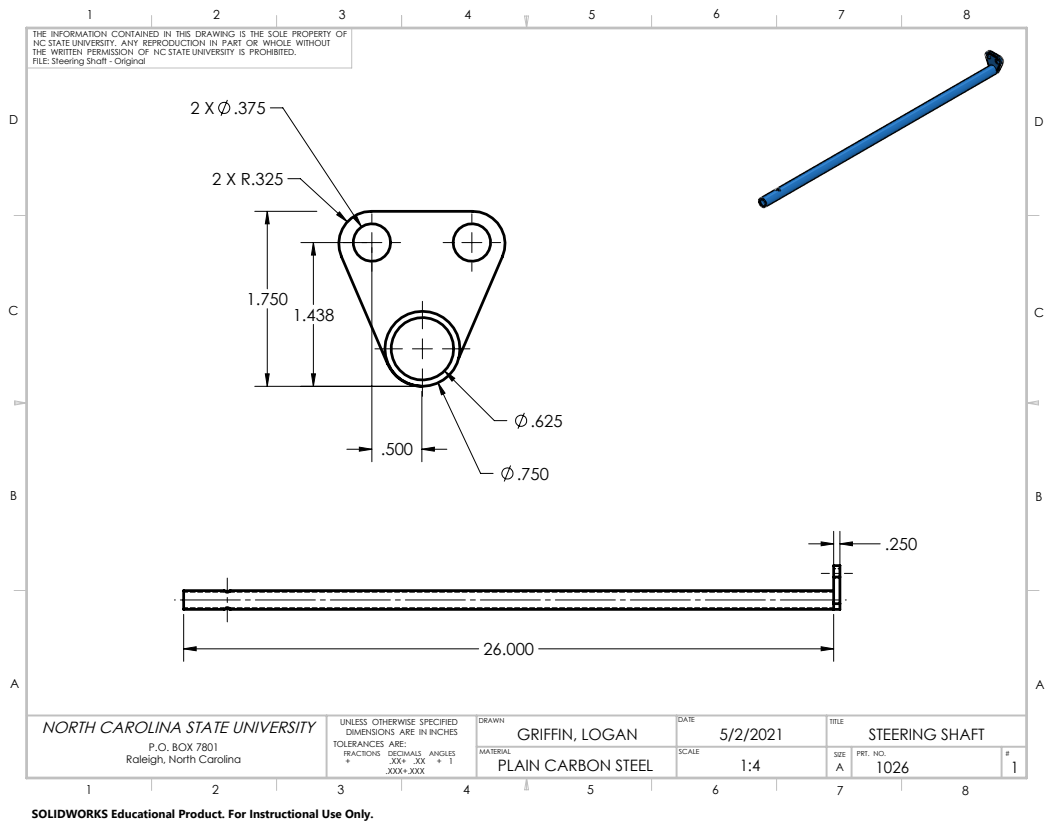
[picture p36: page 1]

THE INFORMATION CONTAINED IN THIS DRAWING IS THE SOLE PROPERTY OF
NC STATE UNIVERSITY. ANY REPRODUCTION IN PART OR WHOLE WITHOUT
THE WRITTEN PERMISSION OF NC STATE UNIVERSITY IS PROHIBITED.
FILE: Steering Shaft - Original

P.O. BOX 7801 Raleigh, North Carolina | UNLESS OTHERWISE SPECIFIED NORTH CAROLINA STATE UNIVERSITY DIMENSIONS ARE IN INCHES TOLERANCES ARE: FRACTIONS DECIMALS ANGLES + .XX+ .XX + 1 .XXX+.XXX | DRAWN GRIFFIN, LOGAN | DATE 5/2/2021 | TITLE STEERING SHAFT

MATERIAL PLAIN CARBON STEEL | SCALE 1:4 | SIZE A | PRT. NO. 1026 | # 1

SOLIDWORKS Educational Product. For Instructional Use Only.
