ldgriffin88/go-kart-modeling/drawings/part-drawings/Steering Wheel - Original - Copy.pdf

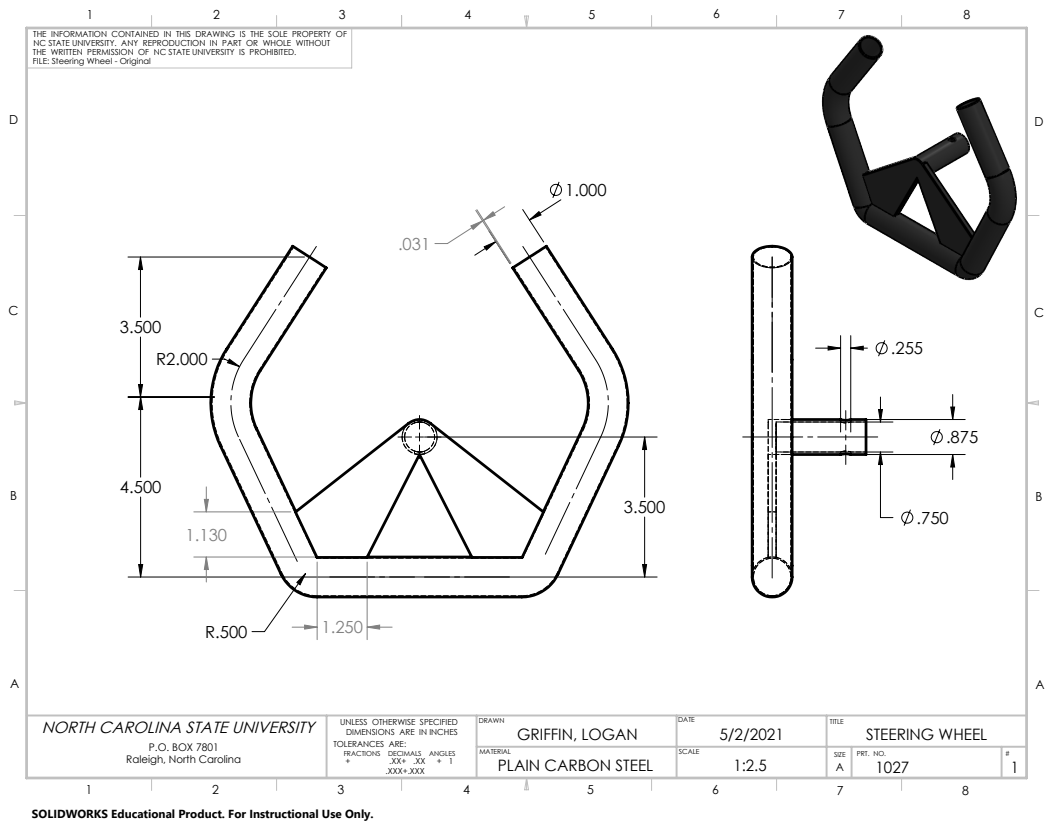
[picture p37: page 1]

THE INFORMATION CONTAINED IN THIS DRAWING IS THE SOLE PROPERTY OF
NC STATE UNIVERSITY. ANY REPRODUCTION IN PART OR WHOLE WITHOUT
THE WRITTEN PERMISSION OF NC STATE UNIVERSITY IS PROHIBITED.
FILE: Steering Wheel - Original

P.O. BOX 7801 Raleigh, North Carolina | UNLESS OTHERWISE SPECIFIED NORTH CAROLINA STATE UNIVERSITY DIMENSIONS ARE IN INCHES TOLERANCES ARE: FRACTIONS DECIMALS ANGLES + .XX+ .XX + 1 .XXX+.XXX | DRAWN GRIFFIN, LOGAN | DATE 5/2/2021 | TITLE STEERING WHEEL

MATERIAL PLAIN CARBON STEEL | SCALE 1:2.5 | SIZE A | PRT. NO. 1027 | # 1

SOLIDWORKS Educational Product. For Instructional Use Only.
